c0nf1ux/a1-mini-painting-station/(list of files, cad)

Other CAD files:
config.scad
modules/bottle_row.scad
config_test.scad
