c0nf1ux/a1-mini-painting-station/(commit log)

2026-09-09 Add project spec for A1 mini modular painting station
    Six connector-compatible modules (bottle row, water reservoir, wet
    holder, scrubber insert, marker holders, handle dock) sized for the
    A1 mini's 180x180x180mm bed, joined by a shared dovetail edge profile.
2026-09-09 Add repo scaffolding: license split, git-lfs config, publish checklist
    MIT for the shared connector library, CC BY-NC-SA 4.0 for module
    designs (protects the monetization path without restricting the
    author's own commercial use). Publish checklist captures the
    real-data-only, print-verified standard for anything that ships
    publicly on MakerWorld/Printables.
2026-09-09 Add implementation plan for six modules + shared connector
    Task-by-task plan covering the dovetail connector library, shared
    config, and all six modules, with automated bed-fit/watertight
    verification via trimesh plus explicit manual checkpoints for the
    physical print/fit/leak tests an agent can't perform.
2026-09-09 Add STL bed-fit/watertight verification script
2026-09-09 Add shared config.scad with tagged parameter provenance
    [config.scad, config_test.scad]
2026-09-09 Add shared dovetail connector library and stub-block test
    Verified: renders watertight, single fused solid (not disjoint
    volumes) via trimesh connected-components check, bed-fit passes,
    visual inspection of both stubs confirms correct trapezoid tab/slot
    shape. Physical fit test is a manual checkpoint before Task 4.
2026-09-10 Note real MakerWorld/Handy limitation: STL uploads need an attached sliced .3mf
2026-09-10 Log real execution findings: task order fix, CGAL volume-count red herring, OrcaSlicer CLI failure, MakerWorld/Handy STL limitation
    Captures what actually happened running Tasks 1-3 versus what the
    plan assumed, plus the exact next steps to resume printing once the
    printer and OrcaSlicer GUI are ready.
2026-09-10 Note Bambuddy as a future option to automate the MakerWorld upload flow
2026-09-10 Add Stage 1 print automation: direct FTPS upload, bypass OrcaSlicer GUI
    Running OrcaSlicer's GUI alongside VS Code chokes this machine. Verified
    live against the printer (file listing + confirmed connector_stubs.gcode.3mf
    already present from today's job). Also documents the OrcaSlicer-close
    aborts-print gotcha this sidesteps, and the Stage 2 MQTT auto-start command
    captured from today's session for the next iteration.
2026-09-10 Add Module 1: bottle row
    Fixed two issues found by rendering+inspecting before commit: well
    spacing (27mm) was narrower than well diameter (28.35mm), merging all 4
    wells into one trough; and wells were cut into the 8mm base_plinth alone,
    which can't hold a bottle upright regardless of well_depth. Wells now cut
    into a separate collar built on top of the shared plinth floor, matching
    the "flush plinth, differing upper geometry" model docs/PROJECT-SPEC.md
    already describes.
    [bottle_row.scad]
2026-09-10 Fix send_to_printer.py: handle printer's FTPS TLS-teardown quirk
    First real large-file upload (bottle_row.gcode.3mf, 1.4MB) crashed on
    conn.unwrap() after a successful transfer -- this printer's FTP server
    doesn't cleanly complete TLS close_notify, and worse, leaves the control
    channel desynced afterward (a later PASV came back malformed). Verify on
    a fresh connection instead of reusing the one upload() just used.
2026-09-10 Add corrected CLI slice profiles after bottle_row print failure
    Test print #1 detached from the plate at ~6mm and spaghetti'd. Root
    cause was not the model (clean watertight solid, no overhangs) but the
    slice: the OrcaSlicer CLI does not resolve bundled presets' `inherits`
    chains, so `Generic PLA @BBL A1M` + `0.20mm Standard @BBL A1M` collapsed
    to program defaults — Cool Plate @ 35C (plate in use needs 65C), 200C
    nozzle, no brim, generic-slow speeds.
    - flatten.py: resolves a preset's full inherits chain into one flat JSON,
    applies overrides.json. Machine preset excluded (stock resolves fine;
    flattened one breaks the CLI).
    - overrides.json: curr_bed_type = Textured PEI Plate, forced 5m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
2026-09-11 Add Module 2 (water reservoir) and Module 4 (scrubber insert)
    Applies the same plinth-height fix bottle_row.scad needed: the plan's
    original Task 5 draft cut a 20mm well straight into the 8mm
    base_plinth_height, which can't hold a well of that depth. Fixed with
    a separate rim wall unioned on top of the plinth, well cut into the
    rim with a 1mm overcut into the plinth top for clean CSG fusion -
    the remaining plinth material becomes the reservoir's floor.
    Scrubber insert gets its own insert_clearance (0.5mm/side) instead of
    reusing the connector's tab_clearance, since it's a part pulled in/out
    by hand, not a printed-in-place snap fit.
    Both rendered, watertight, bed-fit checked, and visually i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
    [scrubber_insert.scad, water_reservoir.scad]
2026-09-11 Fix water reservoir hole: connector slot cut through into well cavity
    edge_slot() cuts 3.7mm deep (tab_depth + 0.2mm overcut) into the x=0
    face, overlapping rounded_well()'s 1mm bite into the plinth since
    wall=3mm was thinner than the slot's reach. The two voids joined into
    one tunnel straight through the connector-side wall — the hole seen on
    the first print. Push the well's inner wall back to 4.5mm on the slot
    side only (tab_depth + overcut + margin), leaving the other three
    sides at 3mm to avoid losing reservoir volume for no reason.
    Verified via trimesh point-containment: the 0.8mm membrane between the
    slot and well cavities now reads SOLID (was void/tunnel before); mesh
    still waterti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
    [water_reservoir.scad]
2026-09-11 Spec: tiered bottle rack redesign (dropper-bottle family)
    Course-correction from the flat single-row bottle_row.scad toward the
    project's original vision (segment the reference design's functional
    bones, not build generic replacements). Sourced real bottle dimensions
    via LITKO's manufacturer fit table (26mm dropper family) instead of a
    single-brand retail proxy; scopes Citadel pots out to a future module
    since they're a genuinely different bottle shape, not just a size
    variant.
    Claude-Session: https://claude.ai/code/session_01L569pvLm68Jp9P34qvsfgf
2026-09-11 Correct bottle_diameter to sourced 26mm, add well_clearance constant
    LITKO's manufacturer fit table (a company that actually makes paint
    racks) covers Vallejo/Army Painter/AK Interactive/Scale75/Reaper/Two
    Thin Coats at 26mm - a stronger source than the old single-listing
    28mm proxy. well_clearance (0.75mm) replaces tab_clearance for wells:
    a hand-inserted bottle needs real clearance, not a snap-fit tolerance.
    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
    [config.scad, config_test.scad]
2026-09-11 Redesign bottle_row.scad as a 2-row tiered stadium rack
    Replaces the flat single row of 4 wells with front/back rows at
    different collar heights (25mm / 45mm) so both rows' labels stay
    visible, matching the functional layout this project's reference
    design actually uses. No angled step face needed - two straight
    vertical prisms of different heights don't overhang. Uses the
    corrected bottle_diameter (26mm) and new well_clearance (0.75mm)
    from config.scad.
    Verified: watertight, single fused volume, bed-fit 138.5x76x53mm,
    point-containment check confirms no connector-slot/well-cavity
    overlap (the bug class just fixed in water_reservoir.scad).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
    [bottle_row.scad]
2026-09-11 Update PROJECT-SPEC.md for the tiered bottle rack course-correction
    Finalizes bottle_diameter at the LITKO-sourced 26mm (was a pending
    28mm cross-check note), documents the new well_clearance parameter,
    rewrites Module 1's entry for the 2-row stadium redesign, flags
    Module 2 as a throwaway alpha pending a combined scrub+trough
    redesign, and documents the connector-slot/well-cavity overlap bug
    class so future modules check for it explicitly.
    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
